Aguscorazza/Maquette_ZG2/ARCHIVES_2023A_maquetteZG2/CMV_ZG2_ARCHIVES_2023A/1-Partie_Théorique/4-Code simulation/ReadMe.txt

Read me
Bonjour, le code modélisation fournie est un code python à ouvrir sur Jupyter Notebook.
Vous pouvez installer anaconda sur votre ordinateur.
Ouvrir jupyter .
Téleverser le code et voilà.
Point d'amélioration : 
Dans le code il manque à retrouver la réponse fréquentielle en oscillation forcée.
