Aguscorazza/Maquette_ZG2/ARCHIVES_2023A_maquetteZG2/CMV_ZG2_ARCHIVES_2023A/1-Partie_Théorique/5-Cablage/Schéma de cablage.pdf

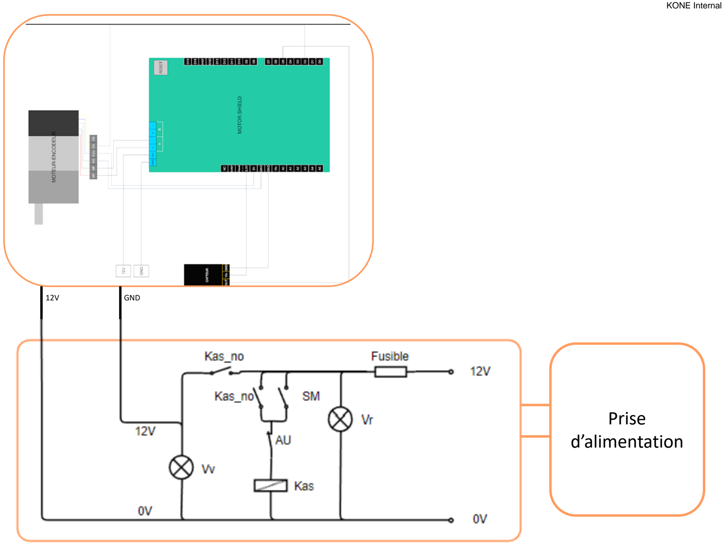
[picture p69: page 1]

KONE Internal

Prise
d’alimentation
12V | GND
