Aguscorazza/Maquette_ZG2/ARCHIVES_2023A_maquetteZG2/CMV_ZG2_ARCHIVES_2023A/READ_ME.docx

Explication de l’organisation des dossiers

0-Tuto

Contient :

- un tuto sur l’installation et le test des différents composants

1-Partie Théorique

Contient:

- un rapport “Rapport technique projet” écrit tout au long du projet sur ce que nous avons fait et les problèmes rencontrés
- un dossier “1-CAO S79P 2023” avec tous les fichiers de CAO du système (pièces, nomenclatures, …)
- un dossier “2-Datasheet” contenant les fiches techniques des composants utilisés pour la maquette
- un dossier “3-schéma” contenant les schémas électrique de la maquette, ainsi que le diagramme fonctionnel

2-Partie Expérimentale

Contient:

- un dossier “1-Analyse_parametre” contenant des test ou nous avons vérifié différents paramètre (temps d'échantillonnage(Te), délai(tps), Correcteur PI(PI)
- un dossier “2-Oscillation libre” contenant les valeurs expérimentales en oscillation libre pour différentes ouverture du gallet d’amortissement
- un dossier “3-Oscillation forcée” contenant les valeurs expérimentales en oscillation forcée pour différentes vitesse du moteur

3-Post Traitement

Contient:

- un rapport sur notre étude de post traitement

4-Code

Contient:

- un dossier “1-IHM” contenant le fichier exécutable de l’ihm et le fichier python de l’ihm
- un dossier ”2-code_arduino” contenant le code arduino en Boucle Ouverte “BO” à utiliser comme base si vous rencontrez des problème de fonctionnement sur la maquette, un code arduino en Boucle Fermée “BF” qui est le code final de fonctionnement de la maquette et 2 code “test_mot” pour tester les différents composants de la maquette
