Aguscorazza/Maquette_ZG2/ARCHIVES_2023A_maquetteZG2/CMV_ZG2_ARCHIVES_2023A/2-Partie_Expérimentale/1-Analyse_parametre/Analyse_Te/Force/bilan.odt

Nombre de points théoriques total à 5ms | 1000
Nombre de points réels total | 720
Période d’échantillonnage réelle (ms) | 6,94444444444444
Temps de calcul (ms) | 1,94444444444444

Nombre de points théoriques total à 10ms | 500
Nombre de points réels total | 487
Période d’échantillonnage réelle (ms) | 10,2669404517454
Temps de calcul (ms) | 0,266940451745381

Nombre de points théoriques total à 15ms | 333,333333333333
Nombre de points réels total | 380
Période d’échantillonnage réelle (ms) | 13,1578947368421
Temps de calcul (ms) | -1,8421052631579

Nombre de points théoriques total à 20ms | 250
Nombre de points réels total | 256
Période d’échantillonnage réelle (ms) | 19,53125
Temps de calcul (ms) | -0,46875
