Aguscorazza/Maquette_ZG2/ARCHIVES_2023A_maquetteZG2/CMV_ZG2_ARCHIVES_2023A/2-Partie_Expérimentale/1-Analyse_parametre/Analyse_Te/Libre/10/bilan.odt

Nombre de points théorique total à 5 ms | 1000
Nombre de points réels total | 607
Période d’échantillonnage réelle (ms) | 8,23723228995058
Temps de calcul (ms) | 3,23723228995058

Nombre de points théorique total à 10 ms | 500
Nombre de points réels total | 453
Période d’échantillonnage réelle (ms) | 11,037527593819
Temps de calcul (ms) | 1,03752759381898

Nombre de points théorique total à 15 ms | 333,333333333333
Nombre de points réels total | 272
Période d’échantillonnage réelle (ms) | 18,3823529411765
Temps de calcul (ms) | 3,38235294117647

Nombre de points théorique total à 20 ms | 250
Nombre de points réels total | 226
Période d’échantillonnage réelle (ms) | 22,1238938053097
Temps de calcul (ms) | 2,12389380530973
