Aguscorazza/Maquette_ZG2/ARCHIVES_2023A_maquetteZG2/CMV_ZG2_ARCHIVES_2023A/1-Partie_Théorique/1-CAO S79P 2023/Ajout 2023P/59_excentrique_V2.stp

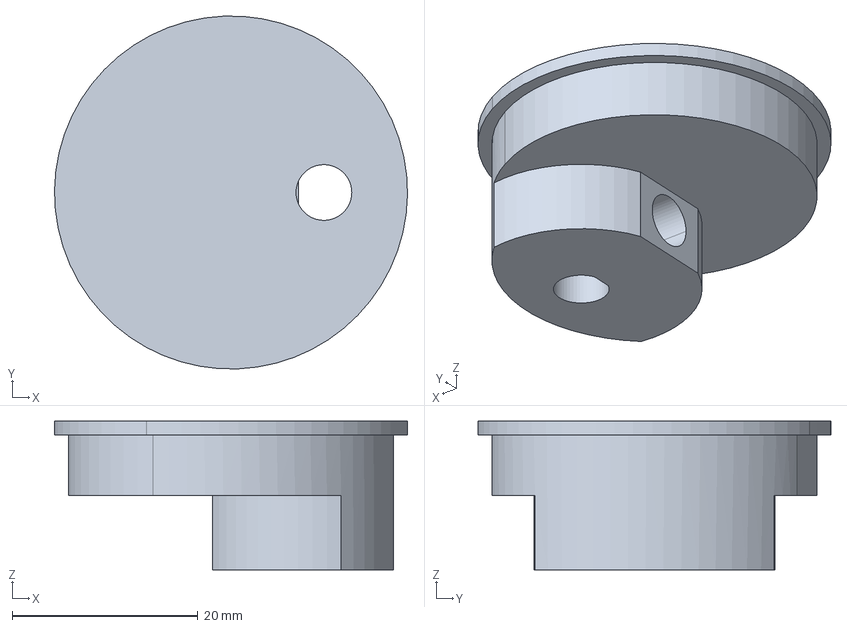
[picture p93: CAD file, 2024-04-01, an earlier design]
ARCHIVES_2023A_maquetteZG2/CMV_ZG2_ARCHIVES_2023A/1-Partie_Théorique/1-CAO S79P 2023/Ajout 2023P/59_excentrique_V2.stp
38.0 x 38.0 x 16.0 mm
