Aguscorazza/Maquette_ZG2/(list of files, cad)

Other CAD files:
ARCHIVES_2023A_maquetteZG2/CMV_ZG2_ARCHIVES_2023A/1-Partie_Théorique/1-CAO S79P 2023/0_ASS_FINAL.CATProduct
ARCHIVES_2023A_maquetteZG2/CMV_ZG2_ARCHIVES_2023A/1-Partie_Théorique/1-CAO S79P 2023/0a_barre_800.CATPart
ARCHIVES_2023A_maquetteZG2/CMV_ZG2_ARCHIVES_2023A/1-Partie_Théorique/1-CAO S79P 2023/0b_barre_700.CATPart
ARCHIVES_2023A_maquetteZG2/CMV_ZG2_ARCHIVES_2023A/1-Partie_Théorique/1-CAO S79P 2023/0c_barre_400.CATPart
ARCHIVES_2023A_maquetteZG2/CMV_ZG2_ARCHIVES_2023A/1-Partie_Théorique/1-CAO S79P 2023/0d_barre_300.CATPart
ARCHIVES_2023A_maquetteZG2/CMV_ZG2_ARCHIVES_2023A/1-Partie_Théorique/1-CAO S79P 2023/10_masse.CATPart
ARCHIVES_2023A_maquetteZG2/CMV_ZG2_ARCHIVES_2023A/1-Partie_Théorique/1-CAO S79P 2023/11_rondelle_D8.CATPart
ARCHIVES_2023A_maquetteZG2/CMV_ZG2_ARCHIVES_2023A/1-Partie_Théorique/1-CAO S79P 2023/12_ecrou_HM8.CATPart
ARCHIVES_2023A_maquetteZG2/CMV_ZG2_ARCHIVES_2023A/1-Partie_Théorique/1-CAO S79P 2023/13_maillon_D4.catpart
ARCHIVES_2023A_maquetteZG2/CMV_ZG2_ARCHIVES_2023A/1-Partie_Théorique/1-CAO S79P 2023/14_rondelle_D3.CATPart
ARCHIVES_2023A_maquetteZG2/CMV_ZG2_ARCHIVES_2023A/1-Partie_Théorique/1-CAO S79P 2023/15_vis chc_M3-20.CATPart
ARCHIVES_2023A_maquetteZG2/CMV_ZG2_ARCHIVES_2023A/1-Partie_Théorique/1-CAO S79P 2023/16_vis_HM8-45.CATPart
ARCHIVES_2023A_maquetteZG2/CMV_ZG2_ARCHIVES_2023A/1-Partie_Théorique/1-CAO S79P 2023/17_fix_ressort.CATPart
ARCHIVES_2023A_maquetteZG2/CMV_ZG2_ARCHIVES_2023A/1-Partie_Théorique/1-CAO S79P 2023/18a_bride_H_fixe.CATPart
ARCHIVES_2023A_maquetteZG2/CMV_ZG2_ARCHIVES_2023A/1-Partie_Théorique/1-CAO S79P 2023/18b_bride_H_amv.CATPart
ARCHIVES_2023A_maquetteZG2/CMV_ZG2_ARCHIVES_2023A/1-Partie_Théorique/1-CAO S79P 2023/19_bride_B_fixe.CATPart
ARCHIVES_2023A_maquetteZG2/CMV_ZG2_ARCHIVES_2023A/1-Partie_Théorique/1-CAO S79P 2023/1_tube.CATPart
ARCHIVES_2023A_maquetteZG2/CMV_ZG2_ARCHIVES_2023A/1-Partie_Théorique/1-CAO S79P 2023/20_rondelle_D6.CATPart
ARCHIVES_2023A_maquetteZG2/CMV_ZG2_ARCHIVES_2023A/1-Partie_Théorique/1-CAO S79P 2023/21_ecrou_HM6.CATPart
ARCHIVES_2023A_maquetteZG2/CMV_ZG2_ARCHIVES_2023A/1-Partie_Théorique/1-CAO S79P 2023/22_vis chc_M6-25.CATPart
ARCHIVES_2023A_maquetteZG2/CMV_ZG2_ARCHIVES_2023A/1-Partie_Théorique/1-CAO S79P 2023/23_vis chc_M6-12.CATPart
ARCHIVES_2023A_maquetteZG2/CMV_ZG2_ARCHIVES_2023A/1-Partie_Théorique/1-CAO S79P 2023/24_vis chc_M6-38.CATPart
ARCHIVES_2023A_maquetteZG2/CMV_ZG2_ARCHIVES_2023A/1-Partie_Théorique/1-CAO S79P 2023/25_vis chc_M3-12.CATPart
ARCHIVES_2023A_maquetteZG2/CMV_ZG2_ARCHIVES_2023A/1-Partie_Théorique/1-CAO S79P 2023/26_vis chc_M3-28.CATPart
ARCHIVES_2023A_maquetteZG2/CMV_ZG2_ARCHIVES_2023A/1-Partie_Théorique/1-CAO S79P 2023/27_patin_billes.catpart
ARCHIVES_2023A_maquetteZG2/CMV_ZG2_ARCHIVES_2023A/1-Partie_Théorique/1-CAO S79P 2023/28_rail_glissierre.catpart
ARCHIVES_2023A_maquetteZG2/CMV_ZG2_ARCHIVES_2023A/1-Partie_Théorique/1-CAO S79P 2023/2_couvercle_inf.CATPart
ARCHIVES_2023A_maquetteZG2/CMV_ZG2_ARCHIVES_2023A/1-Partie_Théorique/1-CAO S79P 2023/30_capteur_lidar.CATPart
ARCHIVES_2023A_maquetteZG2/CMV_ZG2_ARCHIVES_2023A/1-Partie_Théorique/1-CAO S79P 2023/31_support_capteur.CATPart
ARCHIVES_2023A_maquetteZG2/CMV_ZG2_ARCHIVES_2023A/1-Partie_Théorique/1-CAO S79P 2023/32_equerre.CATpart
ARCHIVES_2023A_maquetteZG2/CMV_ZG2_ARCHIVES_2023A/1-Partie_Théorique/1-CAO S79P 2023/33_ecrou_M6_barre.catpart
ARCHIVES_2023A_maquetteZG2/CMV_ZG2_ARCHIVES_2023A/1-Partie_Théorique/1-CAO S79P 2023/34_vis_TFF_M2-10.CATPart
ARCHIVES_2023A_maquetteZG2/CMV_ZG2_ARCHIVES_2023A/1-Partie_Théorique/1-CAO S79P 2023/35_ecrou_HM2.CATPart
ARCHIVES_2023A_maquetteZG2/CMV_ZG2_ARCHIVES_2023A/1-Partie_Théorique/1-CAO S79P 2023/36_Ecrou_M3_barre.CATPart
ARCHIVES_2023A_maquetteZG2/CMV_ZG2_ARCHIVES_2023A/1-Partie_Théorique/1-CAO S79P 2023/3_couvercle_sup.CATPart
ARCHIVES_2023A_maquetteZG2/CMV_ZG2_ARCHIVES_2023A/1-Partie_Théorique/1-CAO S79P 2023/4_tige.CATPart
ARCHIVES_2023A_maquetteZG2/CMV_ZG2_ARCHIVES_2023A/1-Partie_Théorique/1-CAO S79P 2023/5a_piston_a_V2.CATPart
ARCHIVES_2023A_maquetteZG2/CMV_ZG2_ARCHIVES_2023A/1-Partie_Théorique/1-CAO S79P 2023/5b_piston_b_V2.CATPart
ARCHIVES_2023A_maquetteZG2/CMV_ZG2_ARCHIVES_2023A/1-Partie_Théorique/1-CAO S79P 2023/6_chape.CATPart
ARCHIVES_2023A_maquetteZG2/CMV_ZG2_ARCHIVES_2023A/1-Partie_Théorique/1-CAO S79P 2023/7_ressort.CATPart
ARCHIVES_2023A_maquetteZG2/CMV_ZG2_ARCHIVES_2023A/1-Partie_Théorique/1-CAO S79P 2023/8_support_masse.CATPart
ARCHIVES_2023A_maquetteZG2/CMV_ZG2_ARCHIVES_2023A/1-Partie_Théorique/1-CAO S79P 2023/ASS_amortisseur.CATProduct
ARCHIVES_2023A_maquetteZG2/CMV_ZG2_ARCHIVES_2023A/1-Partie_Théorique/1-CAO S79P 2023/ASS_bati.CATProduct
ARCHIVES_2023A_maquetteZG2/CMV_ZG2_ARCHIVES_2023A/1-Partie_Théorique/1-CAO S79P 2023/ASS_equerre.CATProduct
ARCHIVES_2023A_maquetteZG2/CMV_ZG2_ARCHIVES_2023A/1-Partie_Théorique/1-CAO S79P 2023/ASS_equerre_IMP+vis.CATProduct
ARCHIVES_2023A_maquetteZG2/CMV_ZG2_ARCHIVES_2023A/1-Partie_Théorique/1-CAO S79P 2023/ASS_equerre_b.CATProduct
ARCHIVES_2023A_maquetteZG2/CMV_ZG2_ARCHIVES_2023A/1-Partie_Théorique/1-CAO S79P 2023/ASS_glissiere.CATProduct
ARCHIVES_2023A_maquetteZG2/CMV_ZG2_ARCHIVES_2023A/1-Partie_Théorique/1-CAO S79P 2023/Ajout 2023A/38_Pied reglable M6x17.CATPart
ARCHIVES_2023A_maquetteZG2/CMV_ZG2_ARCHIVES_2023A/1-Partie_Théorique/1-CAO S79P 2023/Ajout 2023A/39_Vis CHC M6x20.CATPart
ARCHIVES_2023A_maquetteZG2/CMV_ZG2_ARCHIVES_2023A/1-Partie_Théorique/1-CAO S79P 2023/Ajout 2023A/41_Rail_bornier.CATPart
ARCHIVES_2023A_maquetteZG2/CMV_ZG2_ARCHIVES_2023A/1-Partie_Théorique/1-CAO S79P 2023/Ajout 2023A/42_Bloc_de_jonction.CATPart
ARCHIVES_2023A_maquetteZG2/CMV_ZG2_ARCHIVES_2023A/1-Partie_Théorique/1-CAO S79P 2023/Ajout 2023A/43_Relais.CATPart
ARCHIVES_2023A_maquetteZG2/CMV_ZG2_ARCHIVES_2023A/1-Partie_Théorique/1-CAO S79P 2023/Ajout 2023A/46_Bouton_poussoir.CATPart
ARCHIVES_2023A_maquetteZG2/CMV_ZG2_ARCHIVES_2023A/1-Partie_Théorique/1-CAO S79P 2023/Ajout 2023A/47_Voyant_Rouge.CATPart
ARCHIVES_2023A_maquetteZG2/CMV_ZG2_ARCHIVES_2023A/1-Partie_Théorique/1-CAO S79P 2023/Ajout 2023A/48_Voyant_Vert.CATPart
ARCHIVES_2023A_maquetteZG2/CMV_ZG2_ARCHIVES_2023A/1-Partie_Théorique/1-CAO S79P 2023/Ajout 2023A/49_Branchement_pour_alim.CATPart
ARCHIVES_2023A_maquetteZG2/CMV_ZG2_ARCHIVES_2023A/1-Partie_Théorique/1-CAO S79P 2023/Ajout 2023A/50_Fusibles.CATPart
ARCHIVES_2023A_maquetteZG2/CMV_ZG2_ARCHIVES_2023A/1-Partie_Théorique/1-CAO S79P 2023/Ajout 2023A/51_vis _TCF_M3-12.CATPart
ARCHIVES_2023A_maquetteZG2/CMV_ZG2_ARCHIVES_2023A/1-Partie_Théorique/1-CAO S79P 2023/Ajout 2023A/52_Ecrou HM3.CATPart
ARCHIVES_2023A_maquetteZG2/CMV_ZG2_ARCHIVES_2023A/1-Partie_Théorique/1-CAO S79P 2023/Ajout 2023A/53_Vis_CHC_M6-16.CATPart
ARCHIVES_2023A_maquetteZG2/CMV_ZG2_ARCHIVES_2023A/1-Partie_Théorique/1-CAO S79P 2023/Ajout 2023A/55_arret_d_urgence.CATPart
ARCHIVES_2023A_maquetteZG2/CMV_ZG2_ARCHIVES_2023A/1-Partie_Théorique/1-CAO S79P 2023/Ajout 2023A/64_goulotte.CATPart
ARCHIVES_2023A_maquetteZG2/CMV_ZG2_ARCHIVES_2023A/1-Partie_Théorique/1-CAO S79P 2023/Ajout 2023A/64a_goulotte 260.CATPart
ARCHIVES_2023A_maquetteZG2/CMV_ZG2_ARCHIVES_2023A/1-Partie_Théorique/1-CAO S79P 2023/Ajout 2023A/64b_goulotte 90.CATPart
ARCHIVES_2023A_maquetteZG2/CMV_ZG2_ARCHIVES_2023A/1-Partie_Théorique/1-CAO S79P 2023/Ajout 2023A/64c_goulotte_150.CATPart
ARCHIVES_2023A_maquetteZG2/CMV_ZG2_ARCHIVES_2023A/1-Partie_Théorique/1-CAO S79P 2023/Ajout 2023A/ASS_Arret d_urgence et support.CATProduct
ARCHIVES_2023A_maquetteZG2/CMV_ZG2_ARCHIVES_2023A/1-Partie_Théorique/1-CAO S79P 2023/Ajout 2023A/ASS_Pied.CATProduct
ARCHIVES_2023A_maquetteZG2/CMV_ZG2_ARCHIVES_2023A/1-Partie_Théorique/1-CAO S79P 2023/Ajout 2023A/ASS_elec et plaque.CATProduct
ARCHIVES_2023A_maquetteZG2/CMV_ZG2_ARCHIVES_2023A/1-Partie_Théorique/1-CAO S79P 2023/Ajout 2023A/ASS_elec.CATProduct
ARCHIVES_2023A_maquetteZG2/CMV_ZG2_ARCHIVES_2023A/1-Partie_Théorique/1-CAO S79P 2023/Ajout 2023A/Goulotte courte.CATPart
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
