Aguscorazza/Maquette_ZG2/ARCHIVES_2023A_maquetteZG2/CMV_ZG2_ARCHIVES_2023A/2-Partie_Expérimentale/1-Analyse_parametre/Analyse_tps/test1_masse_20ms.ods

Temps | Postion | Vitesse Moteur | Fréquence aquisition | Temps de simulation | Kp | Ki | Kd
0 | 0 | 0 | 0 | 0 | 0 | 0 | 0
49 | 251 | 0 | 49
78 | 250 | 26 | 29 |  |  |  |  | fréquence moteur (Hz) | 1,33
109 | 248 | 43 | 31 |  |  |  |  | fréquence perturbations (Hz) | 1,37741046831956
139 | 248 | 50 | 30 |  |  |  |  | Nombre point théorique total à 20ms | 750
169 | 247 | 60 | 30 |  |  |  |  | Nombre de point réel total | 497
199 | 247 | 67 | 30 |  |  |  |  | Période d’échantillonnage réelle (ms) | 30,1810865191147
230 | 246 | 70 | 31 |  |  |  |  | Temps de calcul (ms) | 10,1810865191147
260 | 245 | 65 | 30 |  |  |  |  | Nombre de points théorique par période | 37,5
290 | 245 | 72 | 30 |  |  |  |  | Nombre de points réel par période | 24
320 | 245 | 67 | 30
351 | 244 | 70 | 31
380 | 245 | 70 | 29
410 | 239 | 75 | 30
441 | 239 | 77 | 31
470 | 238 | 82 | 29
501 | 237 | 95 | 31
531 | 232 | 101 | 30
562 | 227 | 115 | 31
591 | 225 | 125 | 29
622 | 217 | 142 | 31
652 | 216 | 140 | 30
682 | 209 | 152 | 30
712 | 209 | 157 | 30
743 | 204 | 152 | 31
773 | 205 | 147 | 30
803 | 204 | 130 | 30
834 | 210 | 126 | 31
864 | 212 | 108 | 30
894 | 213 | 102 | 30
924 | 216 | 95 | 30
955 | 221 | 95 | 31
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
