Aguscorazza/Maquette_ZG2/ARCHIVES_2023A_maquetteZG2/CMV_ZG2_ARCHIVES_2023A/2-Partie_Expérimentale/1-Analyse_parametre/Analyse_tps/test1_vide.ods

Temps | Postion | Vitesse Moteur | Période aquisition | Temps de simulation | Kp | Ki | Kd | consigne vitesse moteur | consigne vitesse min | consigne vitesse max | Nombre de pallier
0 | 0 | 0 | 0 | 0 | 0 | 0 | 0 | 0 | 0 | 0 | 0
44 | 245 | 0 | 44
75 | 251 | 30 | 31 |  |  |  |  | fréquence moteur | 1,33HZ
106 | 249 | 50 | 31
136 | 247 | 62 | 30 |  |  |  |  | Nombre point théorique | 750 | À 20 ms
166 | 245 | 79 | 30 |  |  |  |  | Nombre de point réel | 497 | 30,1810865191147
196 | 246 | 90 | 30 |  |  |  |  | Temps de calcul | 10,1810865191147
227 | 244 | 102 | 31 |  |  |  |  | Nombre de point par période
256 | 243 | 106 | 29
287 | 236 | 118 | 31
317 | 232 | 118 | 30
348 | 226 | 120 | 31
378 | 227 | 134 | 30
408 | 223 | 128 | 30
439 | 223 | 135 | 31
468 | 220 | 133 | 29
499 | 219 | 142 | 31
529 | 215 | 133 | 30
560 | 215 | 135 | 31
589 | 214 | 135 | 29
620 | 214 | 137 | 31
650 | 212 | 133 | 30
680 | 214 | 133 | 30
711 | 212 | 142 | 31
741 | 215 | 130 | 30
771 | 213 | 137 | 30
801 | 214 | 135 | 30
832 | 213 | 137 | 31
862 | 212 | 128 | 30
892 | 210 | 132 | 30
922 | 211 | 134 | 30
953 | 214 | 129 | 31
982 | 215 | 125 | 29
1013 | 216 | 125 | 31
1044 | 217 | 120 | 31
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
