Aguscorazza/Maquette_ZG2/ARCHIVES_2023A_maquetteZG2/CMV_ZG2_ARCHIVES_2023A/2-Partie_Expérimentale/1-Analyse_parametre/Analyse_tps/test2_masse_20ms.ods

Temps | Position | Vitesse Moteur | Période acquisition
0 | 0 | 0 | 0 | fréquence moteur (Hz) | 1,33
30 | 210 | 3 | 30 | fréquence perturbations (Hz) | 1,34048257372654
51 | 213 | 33 | 21 | Nombre point théorique total à 20ms | 750
72 | 216 | 67 | 21 | Nombre de point réel total | 687
93 | 219 | 86 | 21 | Période d’échantillonnage réelle (ms) | 21,8340611353712
114 | 221 | 86 | 21 | Temps de calcul (ms) | 1,83406113537118
135 | 223 | 71 | 21 | Nombre de points théorique par période | 37,5
156 | 223 | 67 | 21 | Nombre de points réel par période | 34
177 | 224 | 63 | 21
198 | 226 | 71 | 21
219 | 227 | 70 | 21
240 | 229 | 71 | 21
261 | 229 | 67 | 21
282 | 228 | 71 | 21
313 | 227 | 71 | 31
334 | 227 | 74 | 21
355 | 227 | 71 | 21
376 | 227 | 71 | 21
397 | 227 | 75 | 21
418 | 223 | 78 | 21
439 | 222 | 78 | 21
460 | 224 | 78 | 21
481 | 220 | 82 | 21
502 | 221 | 78 | 21
523 | 224 | 81 | 21
554 | 220 | 82 | 31
575 | 221 | 82 | 21
596 | 222 | 82 | 21
617 | 222 | 86 | 21
638 | 218 | 88 | 21
659 | 215 | 86 | 21
680 | 217 | 86 | 21
701 | 219 | 86 | 21
722 | 220 | 86 | 21
743 | 218 | 85 | 21
764 | 220 | 82 | 21
785 | 223 | 78 | 21
806 | 222 | 71 | 21
837 | 225 | 71 | 31
858 | 226 | 71 | 21
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
