Aguscorazza/Maquette_ZG2/ARCHIVES_2023A_maquetteZG2/CMV_ZG2_ARCHIVES_2023A/2-Partie_Expérimentale/2-Oscillation_libre/Resultat/force.xlsx

250 | Position (50tr/min) | Position (74tr/min) | Position (110tr/min) | Temps | Position (50tr/min) | Position (74tr/min) | Position (110tr/min) | fréquence résonance
233 | 0 | 0 | 0 | 0 | 23 | 28 | 16 | f1 | 0.8333333333
229 | 273 | 261 | 245 | 26 | 19 | 26 | 16 | f2 | 1.233333333
 | 269 | 259 | 245 | 47 | 16 | 24 | 16 | f3 | 1.833333333
 | 266 | 257 | 245 | 68 | 12 | 21 | 10
 | 262 | 254 | 239 | 89 | 10 | 21 | 8
 | 260 | 254 | 237 | 110 | 8 | 20 | 7
 | 258 | 253 | 236 | 131 | 6 | 19 | 4
 | 256 | 252 | 233 | 152 | 5 | 19 | 7
 | 255 | 252 | 236 | 173 | 4 | 19 | 4
 | 254 | 252 | 233 | 194 | 8 | 17 | 5
 | 258 | 250 | 234 | 215 | 5 | 16 | 8
 | 255 | 249 | 237 | 246 | 4 | 16 | 9
 | 254 | 249 | 238 | 267 | 3 | 13 | 6
 | 253 | 246 | 235 | 288 | 4 | 12 | 9
 | 254 | 245 | 238 | 309 | 4 | 12 | 5
 | 254 | 245 | 234 | 330 | 2 | 11 | 7
 | 252 | 244 | 236 | 351 | 1 | 11 | 4
 | 251 | 244 | 233 | 372 | 0 | 11 | -1
 | 250 | 244 | 228 | 393 | 0 | 11 | -3
 | 250 | 244 | 226 | 414 | 3 | 10 | -5
 | 253 | 243 | 224 | 435 | 2 | 6 | -10
 | 252 | 239 | 219 | 456 | -1 | 5 | -11
 | 249 | 238 | 218 | 477 | -2 | 2 | -11
 | 248 | 235 | 218 | 507 | -3 | 3 | -8
 | 247 | 236 | 221 | 528 | -4 | 3 | -9
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
