Aguscorazza/Maquette_ZG2/ARCHIVES_2023A_maquetteZG2/CMV_ZG2_ARCHIVES_2023A/2-Partie_Expérimentale/2-Oscillation_libre/Resultat/libre.xlsx

Temps | Temps corrigé | Position abs | Position | Théorique | Kp | Ki | Kd | Amortissement | consigne vitesse min | consigne vitesse max | Nombre de pallier
1875 | 0 | 27 | 300 | 27 | 0 | 0 | 0 |  | 0 | 0 | 0
1896 | 21 | 26 | 299 | 26.49859605
1917 | 42 | 26 | 299 | 25.3599143 |  |  |  | x0 | 0.26
1941 | 66 | 26 | 299 | 23.32486983 |  |  |  | m | 1.8
1962 | 87 | 24 | 297 | 20.95940031 |  |  |  | k | 100
1983 | 108 | 21 | 294 | 18.11516482 |  |  |  | Décrément loga | 1.504077397
2004 | 129 | 20 | 293 | 14.86740865 |  |  |  | t | 1.875
2025 | 150 | 17 | 290 | 11.30021287 |  |  |  | t+nT | 6.76
2046 | 171 | 12 | 285 | 7.504338277 |  |  |  | n | 6
2067 | 192 | 9 | 282 | 3.57493473 |  |  |  | T | 0.8141666667
2088 | 213 | 6 | 279 | -0.3908266682 |  |  |  | w0 | 7.453559925
2112 | 237 | -1 | 272 | -4.843569084 |  |  |  | t+nT | 6.76
2134 | 259 | -5 | 268 | -8.736338123 |  |  |  | facteur d’amortissement | 0.04130873248
2155 | 280 | -9 | 264 | -12.18747037 |  |  |  | pulsation de raisonnance | 7.44719779
2176 | 301 | -17 | 256 | -15.29819555 |  |  |  | fréquence de raisonnance | 1.18525834
2197 | 322 | -21 | 252 | -17.99731973
2218 | 343 | -25 | 248 | -20.22456255
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
