Aguscorazza/Maquette_ZG2/ARCHIVES_2023A_maquetteZG2/CMV_ZG2_ARCHIVES_2023A/1-Partie_Théorique/1-CAO S79P 2023/Ajout 2023A/Plan/ASS_Excitation.pdf

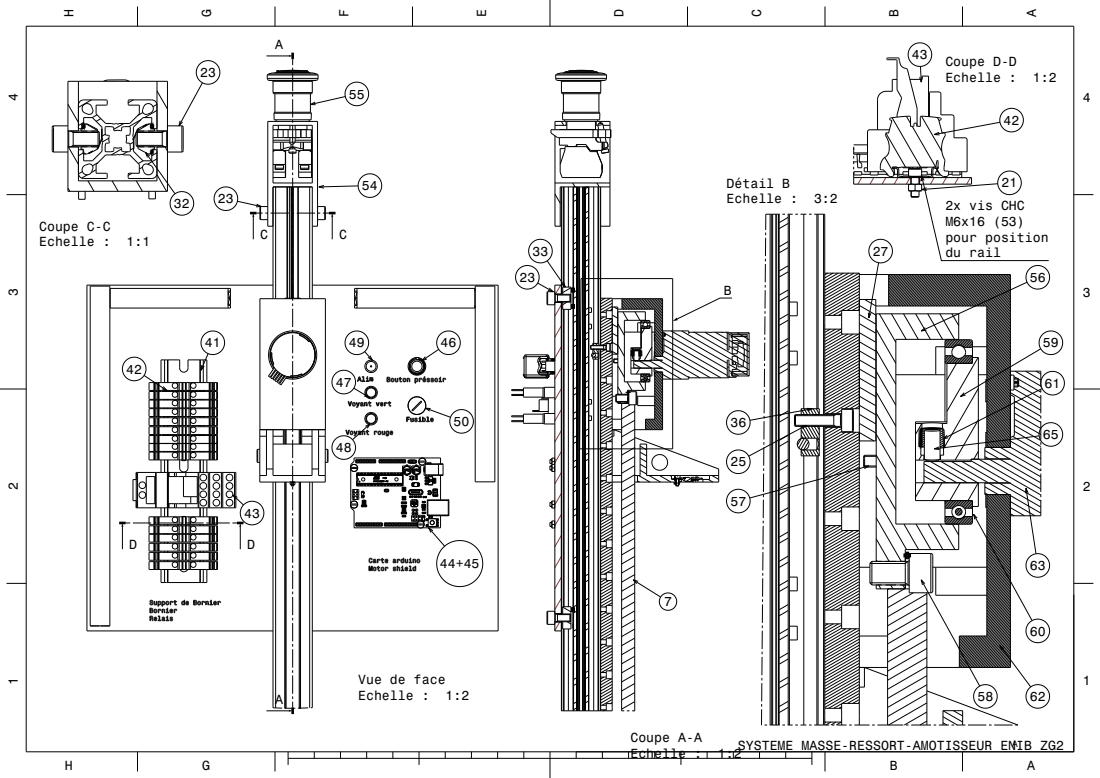
[picture p94: page 1]
Coupe C-C Echelle : 1:1; Coupe A-A Echelle : 1:2; Détail B Echelle : 3:2; Coupe D-D Echelle : 1:2; 2x vis CHC M6x16 (53) pour position du rail

Vue de face
Echelle : 1:2

SYSTEME MASSE-RESSORT-AMOTISSEUR ENIB ZG2
