Aguscorazza/Maquette_ZG2/ARCHIVES_2023A_maquetteZG2/CMV_ZG2_ARCHIVES_2023A/1-Partie_Théorique/1-CAO S79P 2023/Ajout 2023A/Plan/ASS_Excitation_vue éclaté.pdf

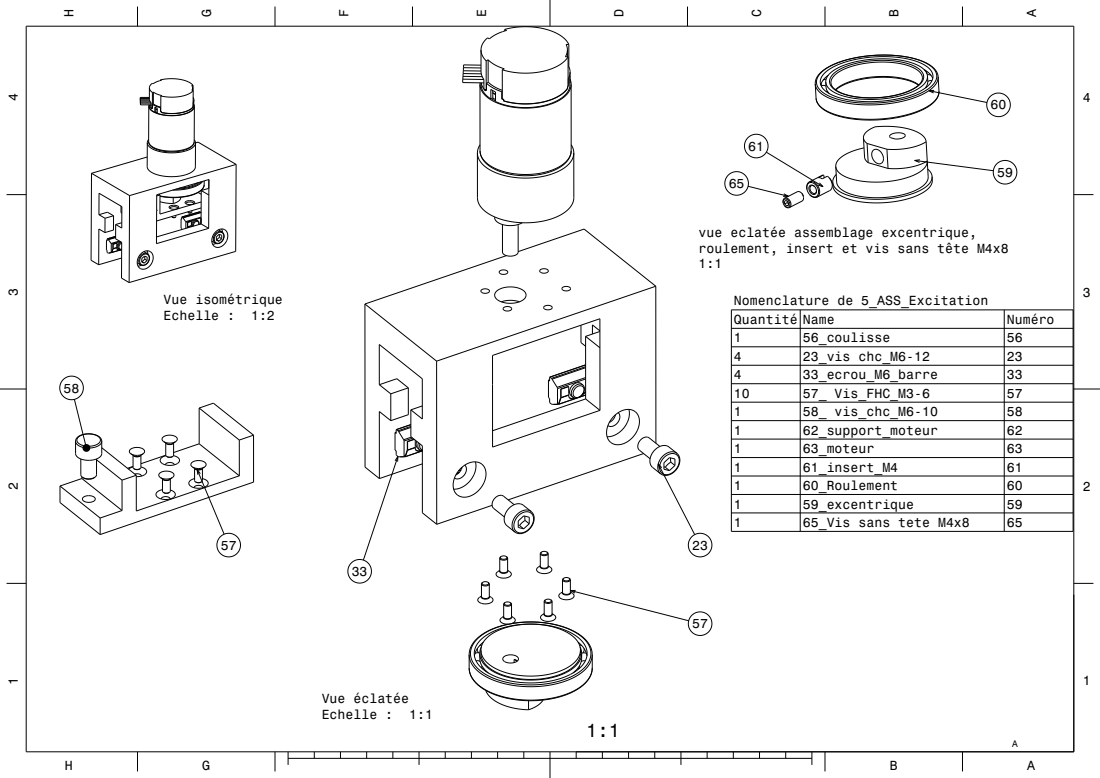
[picture p95: page 1]
Nomenclature de 5_ASS_Excitation; Vue éclatée Echelle : 1:1; Vue isométrique Echelle : 1:2

vue eclatée assemblage excentrique,
roulement, insert et vis sans tête M4x8

Quantité | Name | Numéro
1 | 56_coulisse | 56
4 | 23_vis chc_M6-12 | 23
4 | 33_ecrou_M6_barre | 33
10 | 57_ Vis_FHC_M3-6 | 57
1 | 58_ vis_chc_M6-10 | 58
1 | 62_support_moteur | 62
1 | 63_moteur | 63
1 | 61_insert_M4 | 61
1 | 60_Roulement | 60
1 | 59_excentrique | 59
1 | 65_Vis sans tete M4x8 | 65
