Aguscorazza/Maquette_ZG2/ARCHIVES_2023A_maquetteZG2/CMV_ZG2_ARCHIVES_2023A/1-Partie_Théorique/1-CAO S79P 2023/Ajout 2023P/Plan/vue_eclatee.pdf

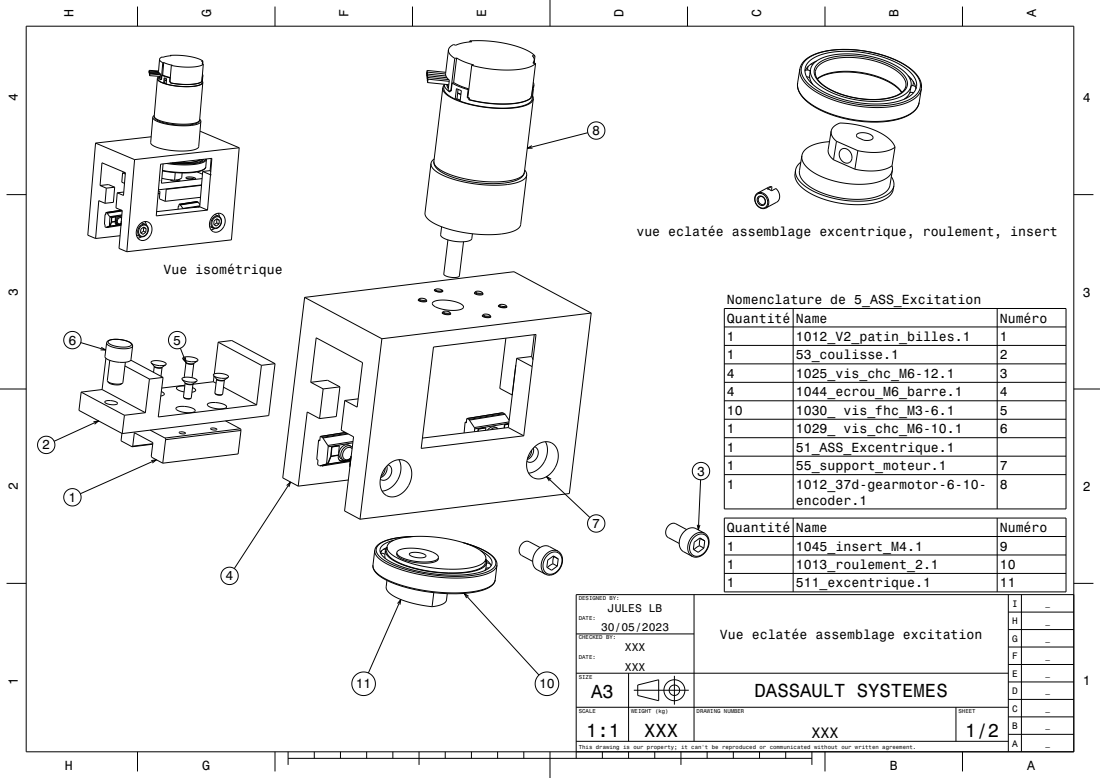
[picture p96: page 1]
CHECKED BY:; Vue isométrique; Nomenclature de 5_ASS_Excitation

vue eclatée assemblage excentrique, roulement, insert

Quantité | Name | Numéro
1 | 1012_V2_patin_billes.1 | 1
1 | 53_coulisse.1 | 2
4 | 1025_vis_chc_M6-12.1 | 3
4 | 1044_ecrou_M6_barre.1 | 4
10 | 1030_ vis_fhc_M3-6.1 | 5
1 | 1029_ vis_chc_M6-10.1 | 6
1 | 51_ASS_Excentrique.1
1 | 55_support_moteur.1 | 7
1 | 1012_37d-gearmotor-6-10-encoder.1 | 8

1 | 1045_insert_M4.1 | 9
1 | 1013_roulement_2.1 | 10
1 | 511_excentrique.1 | 11

DESIGNED BY: JULES LB DATE: 30/05/2023 | Vue eclatée assemblage excitation | I | _

SIZE A3 | | | | DASSAULT SYSTEMES

SCALE 1:1 | WEIGHT (kg) XXX | DRAWING NUMBER XXX | SHEET 1/2

This drawing is our property; it can't be reproduced or communicated without our written agreement.
