Aguscorazza/Maquette_ZG2/ARCHIVES_2023A_maquetteZG2/CMV_ZG2_ARCHIVES_2023A/1-Partie_Théorique/1-CAO S79P 2023/Ajout 2023A/Plan/ASS-sans excitation.pdf

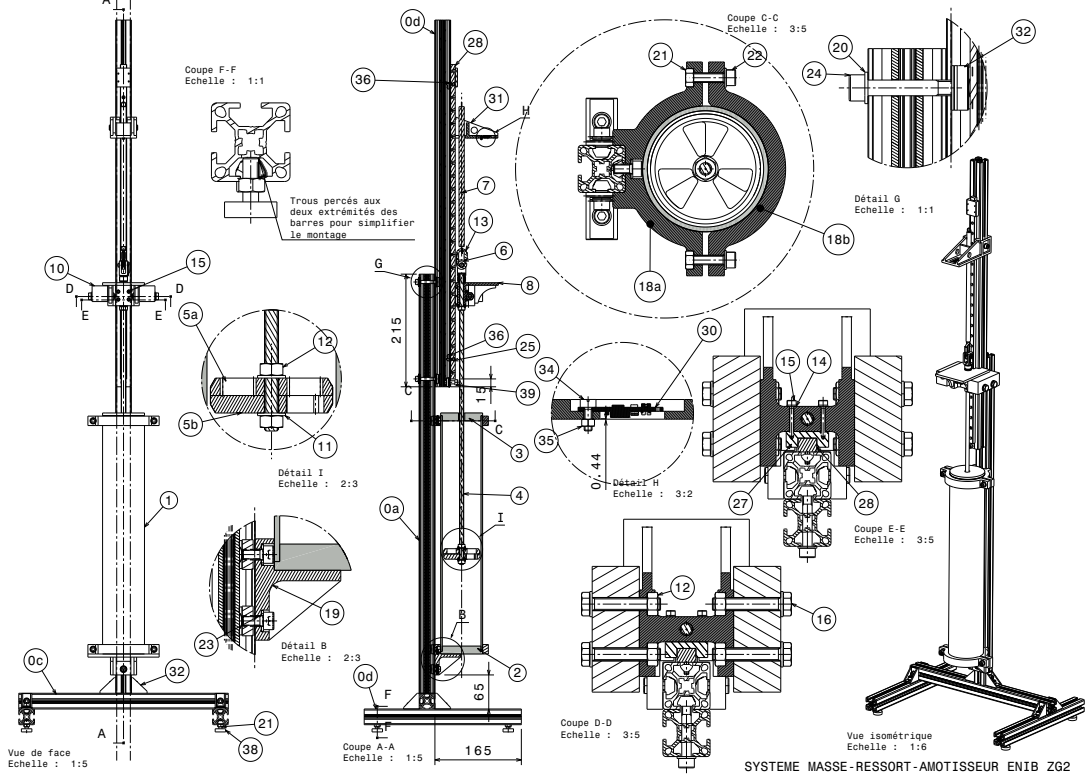
[picture p97: page 1]
Coupe A-A Echelle : 1:5; Détail B Echelle : 2:3; Détail I Echelle : 2:3; Détail G Echelle : 1:1; Coupe C-C Echelle : 3:5; Détail H Echelle : 3:2; Coupe D-D Echelle : 3:5; Coupe E-E Echelle : 3:5; Vue isométrique Echelle : 1:6; Coupe F-F Echelle : 1:1

Trous percés aux
deux extrémités des
barres pour simplifier
le montage

Vue de face
Echelle : 1:5

SYSTEME MASSE-RESSORT-AMOTISSEUR ENIB ZG2
