Aguscorazza/Maquette_ZG2/ARCHIVES_2023A_maquetteZG2/CMV_ZG2_ARCHIVES_2023A/1-Partie_Théorique/1-CAO S79P 2023/Ajout 2023P/Plan/mise en plan excentrique.pdf

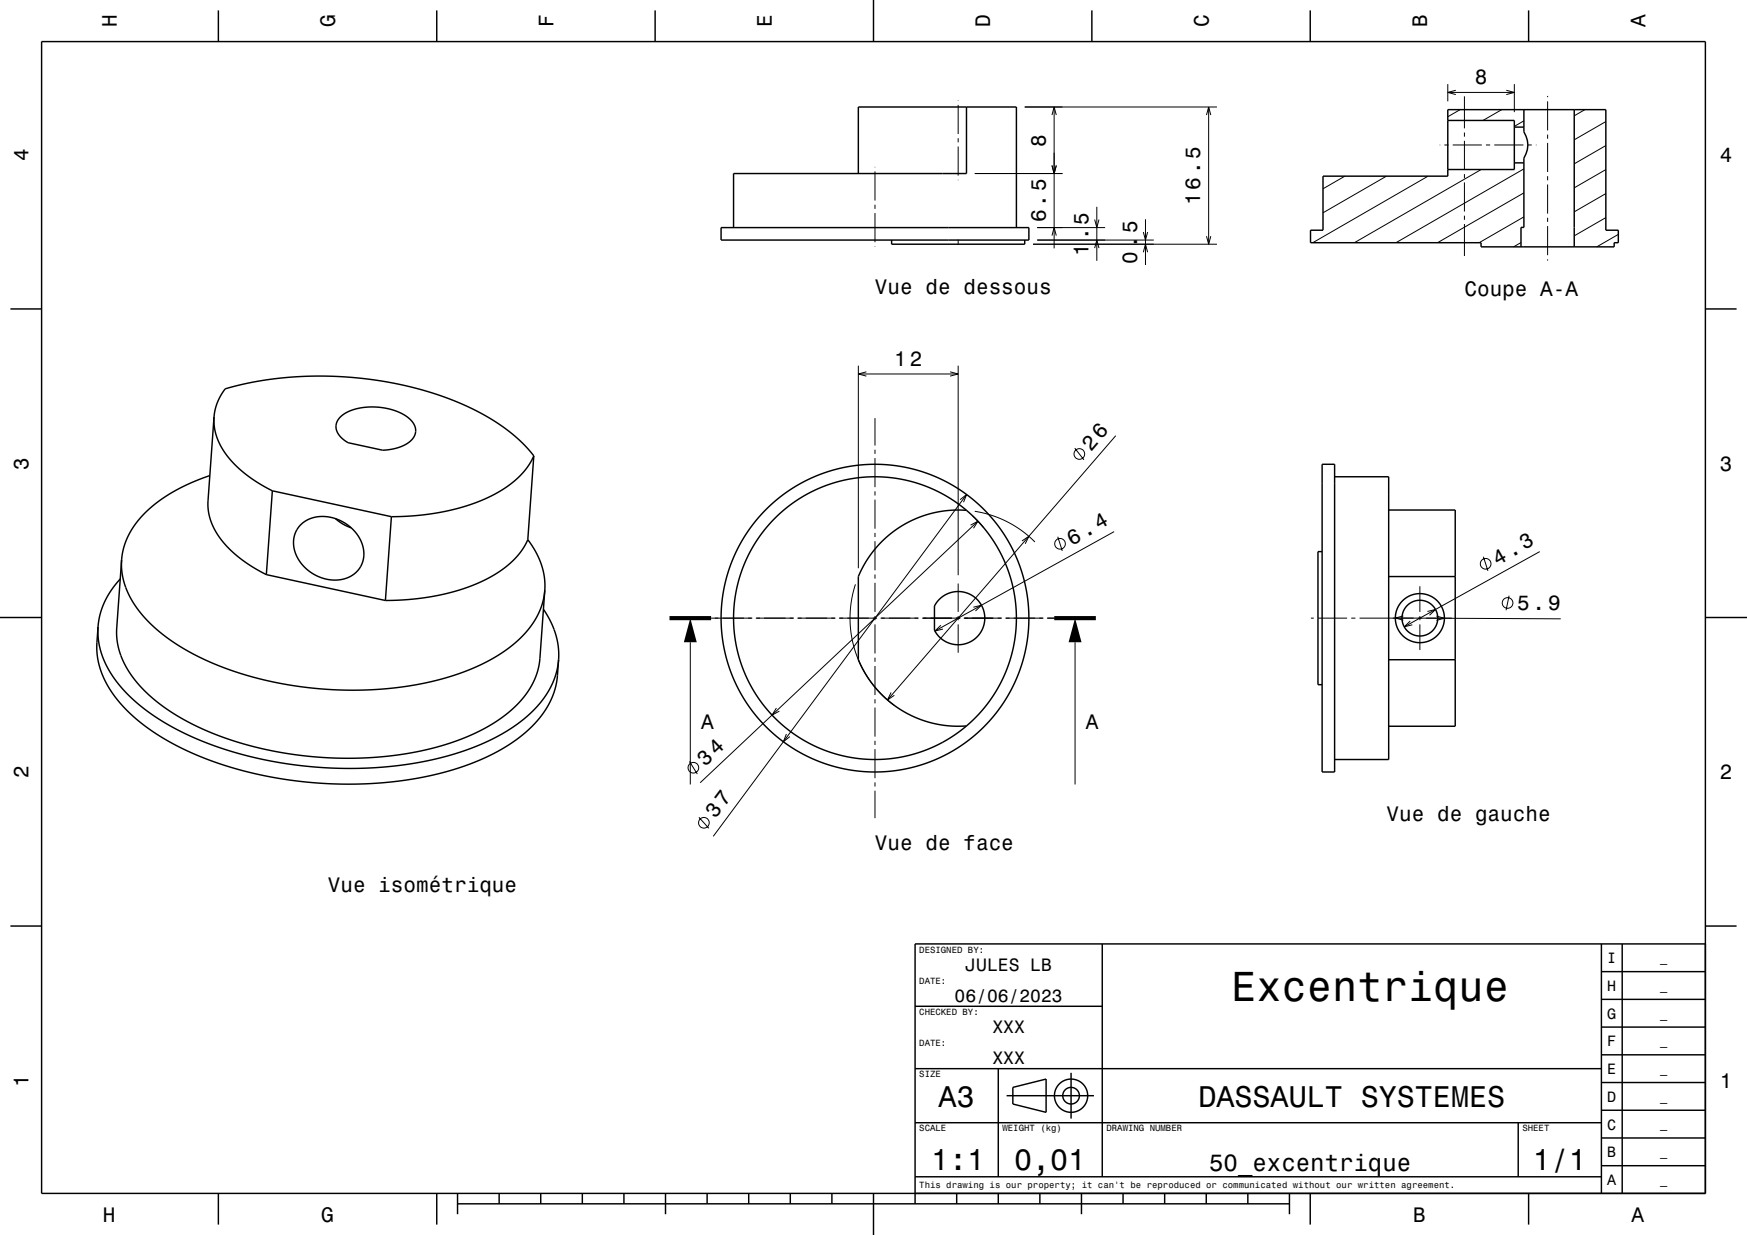
[picture p98: page 1]
CHECKED BY:; Vue isométrique; Coupe A-A

Vue de dessous

Vue de gauche

Vue de face

DESIGNED BY: JULES LB DATE: 06/06/2023 | Excentrique | I | _

SIZE A3 | | | | DASSAULT SYSTEMES

SCALE 1:1 | WEIGHT (kg) 0,01 | DRAWING NUMBER 50_excentrique | SHEET 1/1

This drawing is our property; it can't be reproduced or communicated without our written agreement.
