Aguscorazza/Maquette_ZG2/ARCHIVES_2023A_maquetteZG2/CMV_ZG2_ARCHIVES_2023A/1-Partie_Théorique/1-CAO S79P 2023/Ajout 2023P/Plan/mise en plan.pdf

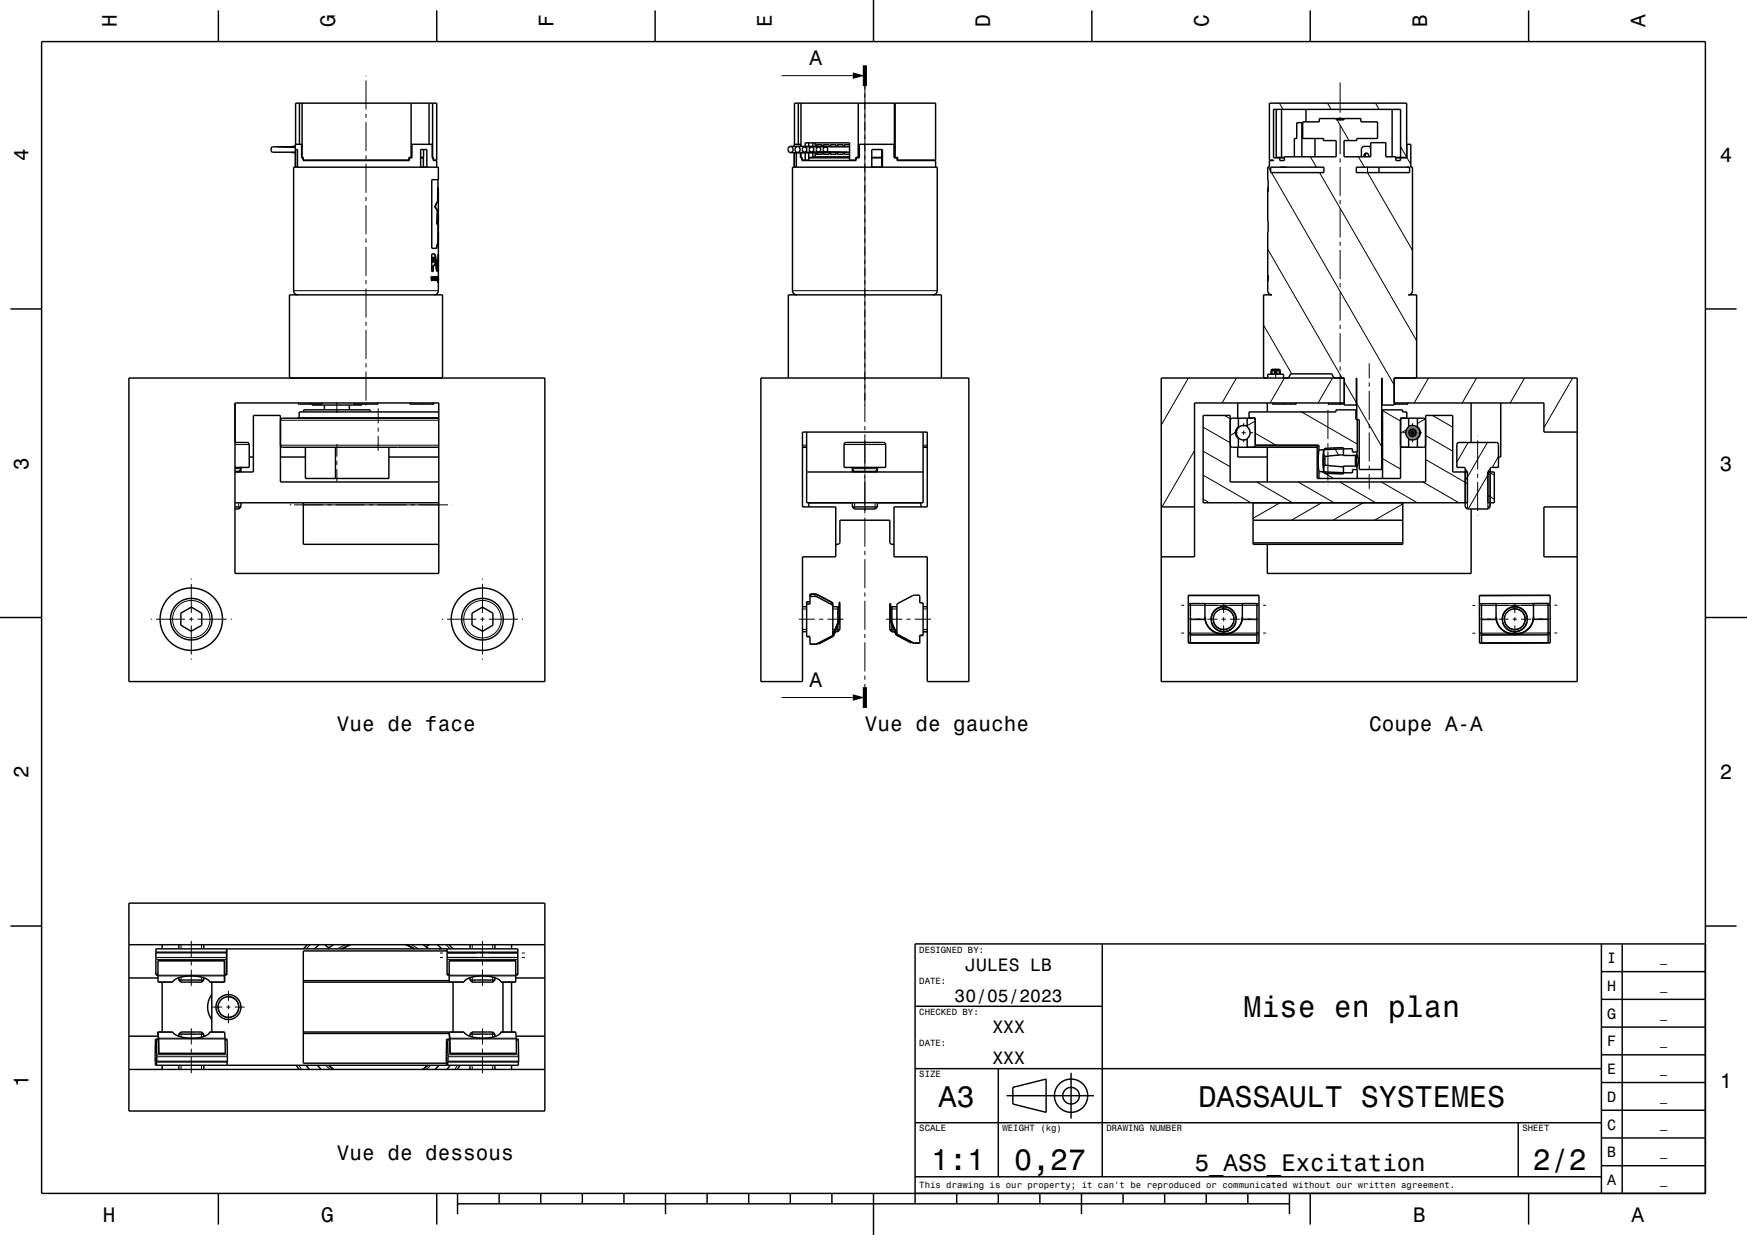
[picture p99: page 1]
CHECKED BY:; Vue de face; Vue de gauche; Coupe A-A

DESIGNED BY: JULES LB DATE: 30/05/2023 | Mise en plan | I | _

SIZE A3 | | | | DASSAULT SYSTEMES

SCALE 1:1 | WEIGHT (kg) 0,27 | DRAWING NUMBER 5_ASS_Excitation | SHEET 2/2

Vue de dessous

This drawing is our property; it can't be reproduced or communicated without our written agreement.
